guillemmmm/RV_SoC/RISC-V TOP/SIM_DE2_115_RISCV_extPROG/RISCV_prog/flash.c

/*  GUILLEM PRENAFETA 2024
 * flash.c
 *
 *  CODE SOURCE LIBRARY FROM::: Copyright (c) 2017 Jim Spicer
 *  https://github.com/jspicer-code/Tiva-C-Embedded/blob/master/LICENSE
 */

#include "flash.h"

#include <stdint.h>
#include <stdio.h>
#include <stdbool.h>

#include "tm4c123gh6pm.h"

//FUNCIONS FLASH

#define FLASH_BASE_ADDR         ((volatile uint32_t*)0x00020000)

// This holds the key required for erase and write operations.  Set it during Enable().
static uint16_t flashKey_ = 0;

void Flash_Enable(void)
{
    // If the KEY flag (bit 4) is set, then the key is 0xA442.
    //  Otherwise, the key is 0x71D5 (pg. 583 of the TM4C123 datasheet).
    if (FLASH_BOOTCFG_R & 0x10) {
        flashKey_ = 0xA442;
    }
    else {
        flashKey_ = 0x71D5;
    }

}

int Flash_Erase(int blockCount)
{

    uint32_t i;
    // Make sure Enable was called.
    if (flashKey_ == 0) {
        return -1;
    }

    for (i = 0; i < blockCount; i++) {

        // Clear then set the OFFSET (17:0) with the write address.
        FLASH_FMA_R &= 0xFFFC0000;

        // Blocks are erased on 1KiB boundaries, so multiply the index by 1024
        //  and add this to the base address.
        FLASH_FMA_R |= ((uint32_t)FLASH_BASE_ADDR) + (i*1024);

        // Set the ERASE command bit.
        FLASH_FMC_R = (flashKey_ << 16) | 0x2;

        // Poll the ERASE bit until it is cleared.
        while (FLASH_FMC_R & 0x2) {}

    }

    return 0;
}


int Flash_Write(uint32_t* data, uint32_t wordCount)
{

    // Make sure Enable was called.
    if (flashKey_ == 0) {
        __nop();
        return -1;
    }

    // Must erase the data first.  A write may only change a bit from 1 to 0, so if the
    //  bit is already zero, the write fails.  Erasing will set all bits to 1's.
    //  Calculate the number of 1KiB blocks that the data will span and erase that many.
    int blockCount = ((wordCount * sizeof(uint32_t)) / 1024) + 1;
    Flash_Erase(blockCount);

    uint32_t i;
    // Write one word at a time...
    for (i = 0; i < wordCount; i++) {

        // Set the data register.  This the word that will be written.
        FLASH_FMD_R = ((volatile uint32_t*)data)[i];

        // Clear then set the OFFSET address field (17:0) with the write address.
        FLASH_FMA_R &= 0xFFFC0000;
        FLASH_FMA_R |= (uint32_t)FLASH_BASE_ADDR + (i * sizeof(uint32_t));

        // Trigger a write operation...
        FLASH_FMC_R = (flashKey_ << 16) | 0x1;

        // Poll the WRITE bit until it is cleared.
        while (FLASH_FMC_R & 0x1) {}

    }

    return 0;

}



void Flash_Read(void* data, uint32_t wordCount)
{
    uint32_t i;
    // Copy the count of bytes into the target data buffer...
    for (i = 0; i < wordCount; i++) {
        ((uint32_t*)data)[i] = FLASH_BASE_ADDR[i];
    }

}
